prdpx7/eletronics-101/car_motor_wiring.jpeg

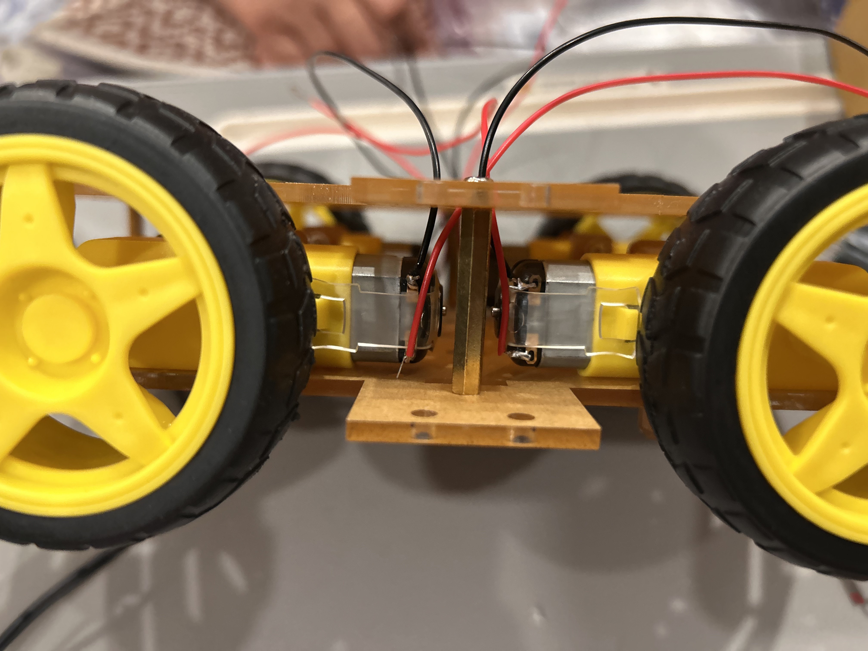
car_motor_wiring.jpeg
