prdpx7/eletronics-101/TBFNG.jpeg

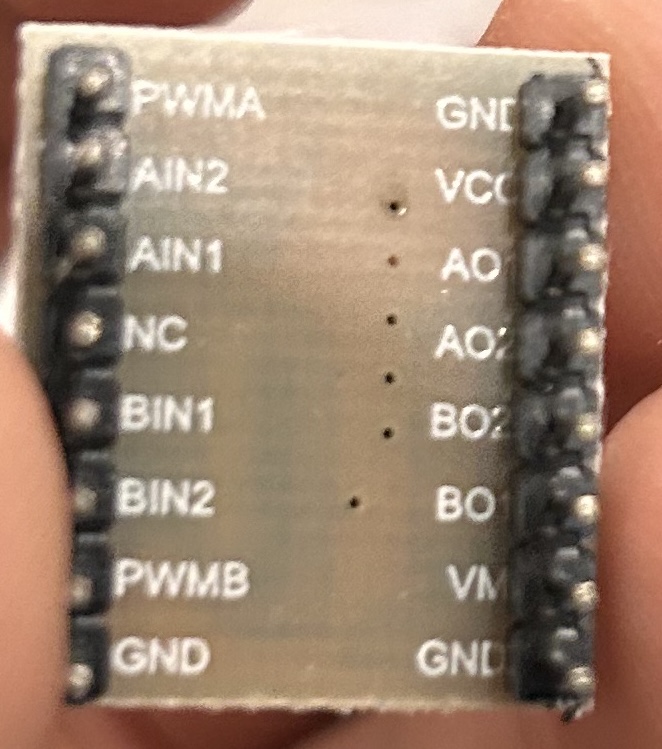
TBFNG.jpeg
