prdpx7/eletronics-101/ESP32.jpeg

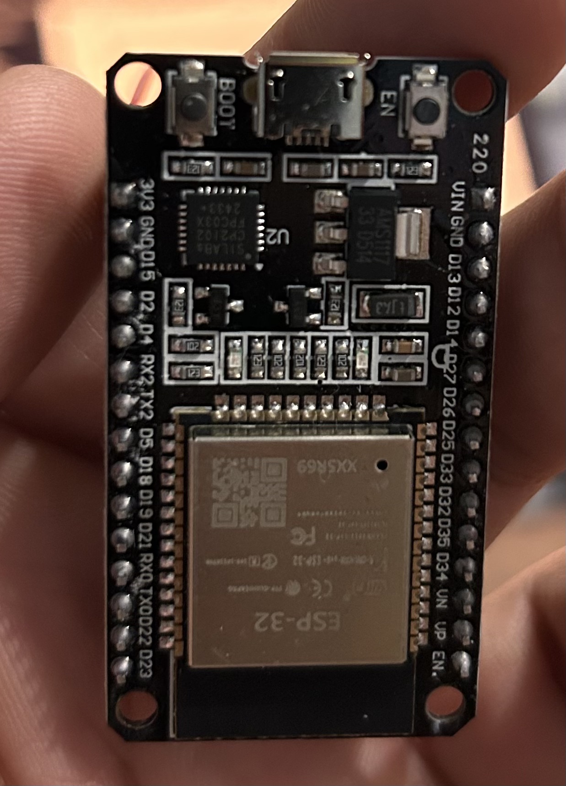
ESP32.jpeg
