prdpx7/eletronics-101/esp32_tbfng_on_breadboard.jpeg

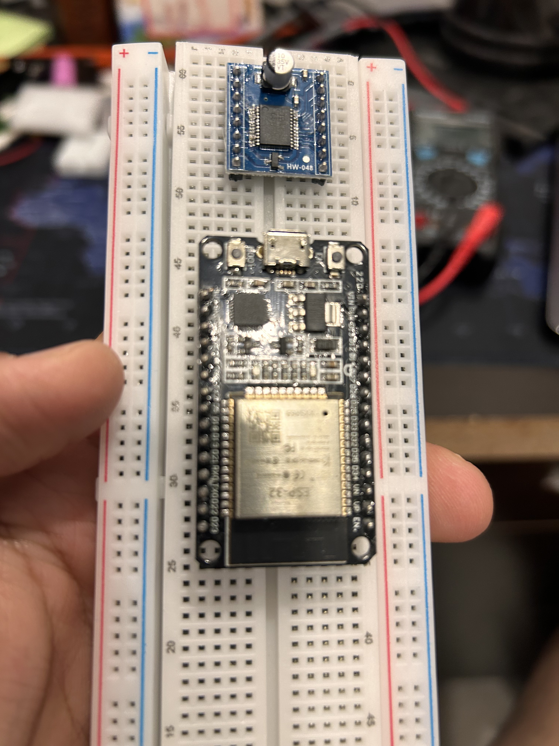
esp32_tbfng_on_breadboard.jpeg
