prdpx7/eletronics-101/(commit log)

2026-04-18 4wd WiFi car - ESP32 + TB6612FNG motor driver
2026-04-18 updated wiring guide
